chipsalliance/rocket-pcblib/CH347F_SOURCE.md

CH347F pin identities follow WCH CH347DS1, version 1C.

The footprint uses the KiCad WQFN-28 land pattern with exposed pad number 0.
KiCad library assets use CC-BY-SA-4.0 with the library exception.

The STEP model follows WCH CH347DS1 V1.4, section 7.1, page 12 (Chinese edition).
The body is 4.0 x 4.0 mm and the total height is 0.75 mm.
Lead pitch is 0.4 mm. Leads are 0.2 mm wide and 0.35 mm long.
The exposed pad is 2.7 x 2.7 mm. The contact plane is Z=0.
The model rotates the manufacturer package to match footprint pin 1 at upper left.
The pin mark, exposed-pad corner chamfer and display colors are simplified.
They do not define manufacturing tolerances.

This project-generated dimensional model uses the repository Apache-2.0 license.
Model offset and rotation are zero. Scale is one.

Source: https://www.wch.cn/downloads/CH347DS1_PDF.html

Exposed pad 0 uses four separate paste apertures, as described in KLC F6.3.
The copper pad intentionally omits F.Paste to avoid a full-area stencil opening.
