chipsalliance/rocket-pcblib/(commit log)

2023-05-17 *.kicad_mod: use ${KIPRJMOD}/library as library path
2023-05-17 *.kicad_sym: add JLCPCB Rotation Offset -180 for sot-23*
2023-05-17 Vowstar_Connector.*: add new symbol, footprint, 3dshapes
2023-05-17 Vowstar_Interface.*: add new symbol, footprint, 3dshapes
2023-05-17 Sensor.kicad_sym: Add magnet logo to DRV5053PAQDBZR
2023-05-17 Comparator.kicad_sym: fix text position of TLV7041DBV
2023-05-17 Connector.*: add ACA-SPI-004-K02 SPI flash socket
2023-05-17 Interface.kicad_sym: fix STUSB03EQR symbol
2023-05-17 Connector.pretty/ACA-SPI-004.kicad_mod: fix arc
2023-05-17 Connector.kicad_sym: add Conn_JTAG_20 and USBC plug
2023-05-17 Interface.kicad_sym: adjust pins of stusb03
2023-05-17 Logic.kicad_sym: add level shifter
2023-05-17 Regulator_Switching.kicad_sym: add MT2492 DC-DC regulator
2023-05-17 Regulator_Switching.kicad_sym: fix MT2492 pin number
2023-05-17 Logic.kicad_sym: add TXS02612RTWR
2023-05-17 Mechanical.kicad_sym: add mounting holes and fiducials
2023-05-17 CHIPSAlliance_Connector.kicad_sym: fix USB_C_Receptacle
2023-05-17 CHIPSAlliance_Interface.kicad_sym: add cp2104
2023-05-17 Logic.kicad_sym: add missing GND pin of TXS02612RTWR
2023-05-17 Power.kicad_sym: add power symbols
2023-05-17 Sensor: add GX0011D thermometer
2023-05-17 Connector.3dshapes: fix color of ASP-134604-01
2023-05-17 Connector.3dshapes: fix color of ACA-SPI-004-K01
2023-05-17 ogic.pretty: add footprint of WQFN-24
2023-05-17 Logic.kicad_sym: fix footprint and 3d model of TXS02612RTWR
2023-05-17 Connector.*: add 3d model and footprint of microSD
    Add microSD_HC_Molex_104031-0811
2023-05-17 Connector.*: fix USB_C_Receptacle_Molex_105450-0101 3d model
2023-05-17 Connector.*: fix F.fab layer of ACA-SPI-004-K02
2023-05-17 MountingHole.pretty: add M2.5 MountingHole for FMC
2023-05-17 CHIPSAlliance_LED.*: Add WS2812 symbol and footprint
2023-05-17 Connector.kicad_sym: fix microSD contact style
    Change the microSD contact on the opposite side to a dashed line
2023-05-17 CHIPSAlliance_Interface.kicad_sym: add ch9102f
2023-05-17 Interface.kicad_sym: add discription to STUSB03EQR
2023-05-17 Interface.pretty/QFN_B03EQR_STM.kicad_mod: add pin 1 dot
2023-05-17 *.kicad_mod: add pin 1 dot
2023-05-17 *.3dshapes,*.pretty: add footprint QFN-24-1EP_4x4mm_P0.5mm_EP2.6x2.6mm
2023-05-17 Interface.kicad_sym: fix QFN footprint link
2023-06-16 Connector.*: add BTB connectors for HRS
    - add HRS_DF40C_60DP_0.4V_51
    - add HRS_DF40C_60DS_0.4V_51
2023-06-16 Interface: add USB3280 Hi-Speed USB Device PHY with UTMI Interface lib
2023-12-07 Connector.*: add PMOD 2x6 pinheader and pinsocket
2023-12-08 Power_Protection: Add TVS Diode for ESD proction
    - Add RCLAMP0524P and TPD4E02B04DQAR symbol
    - Add USON-10_2.5x1.0mm_P0.5mm footprint
    - Add USON-10_2.5x1.0mm_P0.5mm.wrl 3D model
2024-01-05 Connector.*: add microSD_HC_Molex_503398-1892 footprint
    - Add microSD_HC_Molex_503398-1892 3D model
    - Add microSD_HC_Molex_503398-1892 PCB footprint
2024-02-28 Package_TO_SOT_SMD: add SOT-23-* footprints and 3d shapes
    - add SOT-23-3
    - add SOT-23-5
    - add SOT-23-6
    - add SOT-23-8
2024-03-03 Regulator_Switching: Add TPS53647 & TPS53667 symbol and footprint
    - Add TPS53647 & TPS53667 symbol
    - Add Texas RTA0040B footprint and generated 3d model
2024-03-03 Driver_FET: add TI CSD95491 power stage
    - Driver_FET: add library and CSD95491
    - Package_DFN_QFN: add Texas VSON-CLIP 12pin footprint
    - Package_DFN_QFN: add TI 3dshape for VSON-CLIP
2024-03-19 Regulator_Switching: add TLV62130x
2024-03-26 CHIPSAlliance_Connector: Add SODIMM symbol and Foxconn socket
2024-03-26 CHIPSAlliance_*: Add TPS51716 & AON7544 for DDR4 power solution
2024-04-21 CHIPSAlliance_*: fix minor issues in library
    - fix SH pin number in DDR4 SODIMM conn
    - add correct RHL14 package for TPS54821
2024-04-25 CHIPSAlliance_Connector: add QSFP+ connector and cage
    Note: footprint drawn accourding to specs from:
    https://item.taobao.com/item.htm?id=671185861078
2024-05-16 PCIexpress-KiCad: add submodule
2024-05-16 CHIPSAlliance_Connector: add 3dshapes for various connectors
2024-05-26 CHIPSAlliance_Interface: add CH343P USB-UART IC
2024-11-01 CHIPSAlliance_*: update symbols & footprints & 3dmodels for fpga_candelabra
2024-11-11 CHIPSAlliance_*: Update some 3dmodels & footprints
2024-11-14 CHIPSAlliance_Connector: use Droid Mono font for mikrobus silkscreen texts
2026-01-06 CHIPSAlliance_Reference_Current: adde DS4424 4-channel I2C current DAC
    - Add DFN-14-1EP footprint with 3x3mm package and 0.4mm pitch.
    - Add DS4424 symbol for four-channel I2C current DAC.
    - Include 3D STEP model for DFN-14-1EP package visualization.
2026-01-07 CHIPSAlliance_Package_TO_SOT_SMD: replaced VRML models with STEP format
    - Added STEP 3D models for SOT-23 package variants (3, 5, 6, 8-pin).
    - Removed legacy VRML 3D models in favor of modern STEP format.
    - Updated KiCAD footprint files to reference new STEP models.
    - Improved footprint silkscreen markers from circles to triangles for pin 1 identification.
    - Updated footprint generator version from 8.0 to 9.0 across all SOT-23 variants.
2026-01-07 CHIPSAlliance_Diode_SMD: add footprints and 3D models for various SOD packages
    - Added STEP 3D models for SOD-110, SOD-123, SOD-123F, SOD-128, SOD-323, SOD-323F, SOD-523, SOD-882, SOD-882D, and SOD-923.
    - Added KiCAD footprint files (.kicad_mod) for the corresponding SOD packages.
2026-01-07 CHIPSAlliance_Diode: add symbols for BAS series diodes
    - Added symbol for BAS116 low-leakage diode in SOT-23 package.
    - Added symbols for BAS19, BAS20, and BAS21 high-speed switching diodes in SOT-23 package.
    - Added symbols for BAS316 (SOD-323) and BAS516 (SOD-523) high-speed switching diodes.
2026-01-08 CHIPSAlliance_Amplifier_Operational.kicad_sym: renamed from *Operational_Amplifier.kicad_sym
    - Rename symbol library file to follow naming conventions.
    - Replace LMV321 symbol with expanded LM321 symbol library.
2026-01-08 CHIPSAlliance_Package_TO_SOT_SMD: add footprints and 3D models for SC-70 series
    - Added STEP 3D models for SOT-323 (SC-70), SOT-343 (SC-70-4), SOT-353 (SC-70-5), and SOT-363 (SC-70-6).
    - Added KiCAD footprint files (.kicad_mod) for the corresponding SC-70 package variants.
2026-01-08 CHIPSAlliance_Regulator_Linear: added XC6206PxxxMR linear regulator
    - Add XC6206PxxxMR linear regulator symbol to KiCad library.
    - Include datasheet link and footprint filter for SOT-23 package.
2026-01-08 CHIPSAlliance_Amplifier_Operational: added TLV6001DBV operational amplifier
    - Add TLV6001DBV operational amplifier symbol to KiCad library.
    - Configure SOT-23-5 footprint and datasheet link.
2026-01-09 CHIPSAlliance_Regulator_Linear: added TLV70233 linear regulator symbol
    - Add TLV70233 linear regulator symbol for KiCad library.
    - Define pin layout and properties for SOT-23-5 package.
2026-01-09 CHIPSAlliance_Reference_Current: added EP pad pin to DS4424
    - Add EP pad pin as GND to component symbol DS4424
2026-04-05 CHIPSAlliance_Connector: exclude PCIE edge from BOM
2026-10-13 CHIPSAlliance_Sensor: add QMC6308
    Reuse and correct the shared WLP4 footprint and model.
2026-10-13 CHIPSAlliance_Sensor: align symbols and packages with KLC
    Use 0.15 mm WLCSP courtyard clearance as a KLC exception.
2026-10-13 CHIPSAlliance_Sensor: fix MMC5603NJ ground pin name
2026-10-20 CHIPSAlliance_*: add ft-link connector, resonator and solder jumper
2026-11-10 CHIPSAlliance_*: add CH347F USB JTAG and UART bridge
2026-11-10 CHIPSAlliance_Connector: add Hirose FPC connector footprints
2026-11-14 CHIPSAlliance_*: add FPC connector and CH347F STEP models
